scramble-robot/JRT2023_Arduino/パーツリスト.xlsx

Part | Name | Value
BZ1 | ブザー | UDB-05LFPN
C1 | 電解コンデンサ | 1000uF
C2 | 電解コンデンサ | 1000uF
CN1 | VHコネクタ | 2pin
CN2 | VHコネクタ | 2pin
CON1 | e-con | 3pin×4列
CON2 | e-con | 3pin×4列
CON3 | e-con | 3pin×4列
CON4 | e-con | 3pin×4列
CON5 | e-con | 3pin×4列
CON6 | e-con | 3pin×4列
CON7 | e-con | 4pin×4列
CON8 | e-con | 4pin
CON9 | e-con | 4pin
CON10 | e-con | 3pin×4列
IC1 | シールド用ArduinoMega | 8pin×7 6pin×1 10pin×2
LED1 | チップLED | 赤
LED2 | チップLED | 赤
LED3 | チップLED | 赤
LED4 | チップLED | 赤
LED5 | チップLED | 青
LED6 | チップLED | 青
LED7 | チップLED | 青
LED8 | チップLED | 青
LED9 | チップLED | 緑
LED10 | チップLED | 緑
LED11 | チップLED | 緑
LED12 | チップLED | 緑
LED13 | チップLED | 黄
LED14 | チップLED | 黄
LED15 | チップLED | 黄
LED16 | チップLED | 黄
LED17 | チップLED | 白
LED18 | チップLED | 白
R1 | チップ抵抗 | 1kΩ
R2 | チップ抵抗 | 1kΩ
R3 | チップ抵抗 | 1kΩ
R4 | チップ抵抗 | 1kΩ
R5 | チップ抵抗 | 1kΩ
R6 | チップ抵抗 | 1kΩ
R7 | チップ抵抗 | 1kΩ
R8 | チップ抵抗 | 1kΩ
R9 | チップ抵抗 | 1kΩ
R10 | チップ抵抗 | 1kΩ
R11 | チップ抵抗 | 1kΩ
R12 | チップ抵抗 | 1kΩ
R13 | チップ抵抗 | 1kΩ
R14 | チップ抵抗 | 1kΩ
R15 | チップ抵抗 | 1kΩ
R16 | チップ抵抗 | 1kΩ
R17 | チップ抵抗 | 10kΩ
R18 | チップ抵抗 | 1kΩ
R19 | チップ抵抗 | 1kΩ
R20 | チップ抵抗 | 1kΩ
R21 | チップ抵抗 | 1kΩ
RN1 | 集合抵抗 | 10kΩ
RN2 | 集合抵抗 | 10kΩ
RN3 | 集合抵抗 | 10kΩ
RN4 | 集合抵抗 | 10kΩ
T1 | チップトランジスタ | 2SC2712
