scramble-robot/JRT2023_Arduino/PDF/sch.pdf

# Motor

# LED

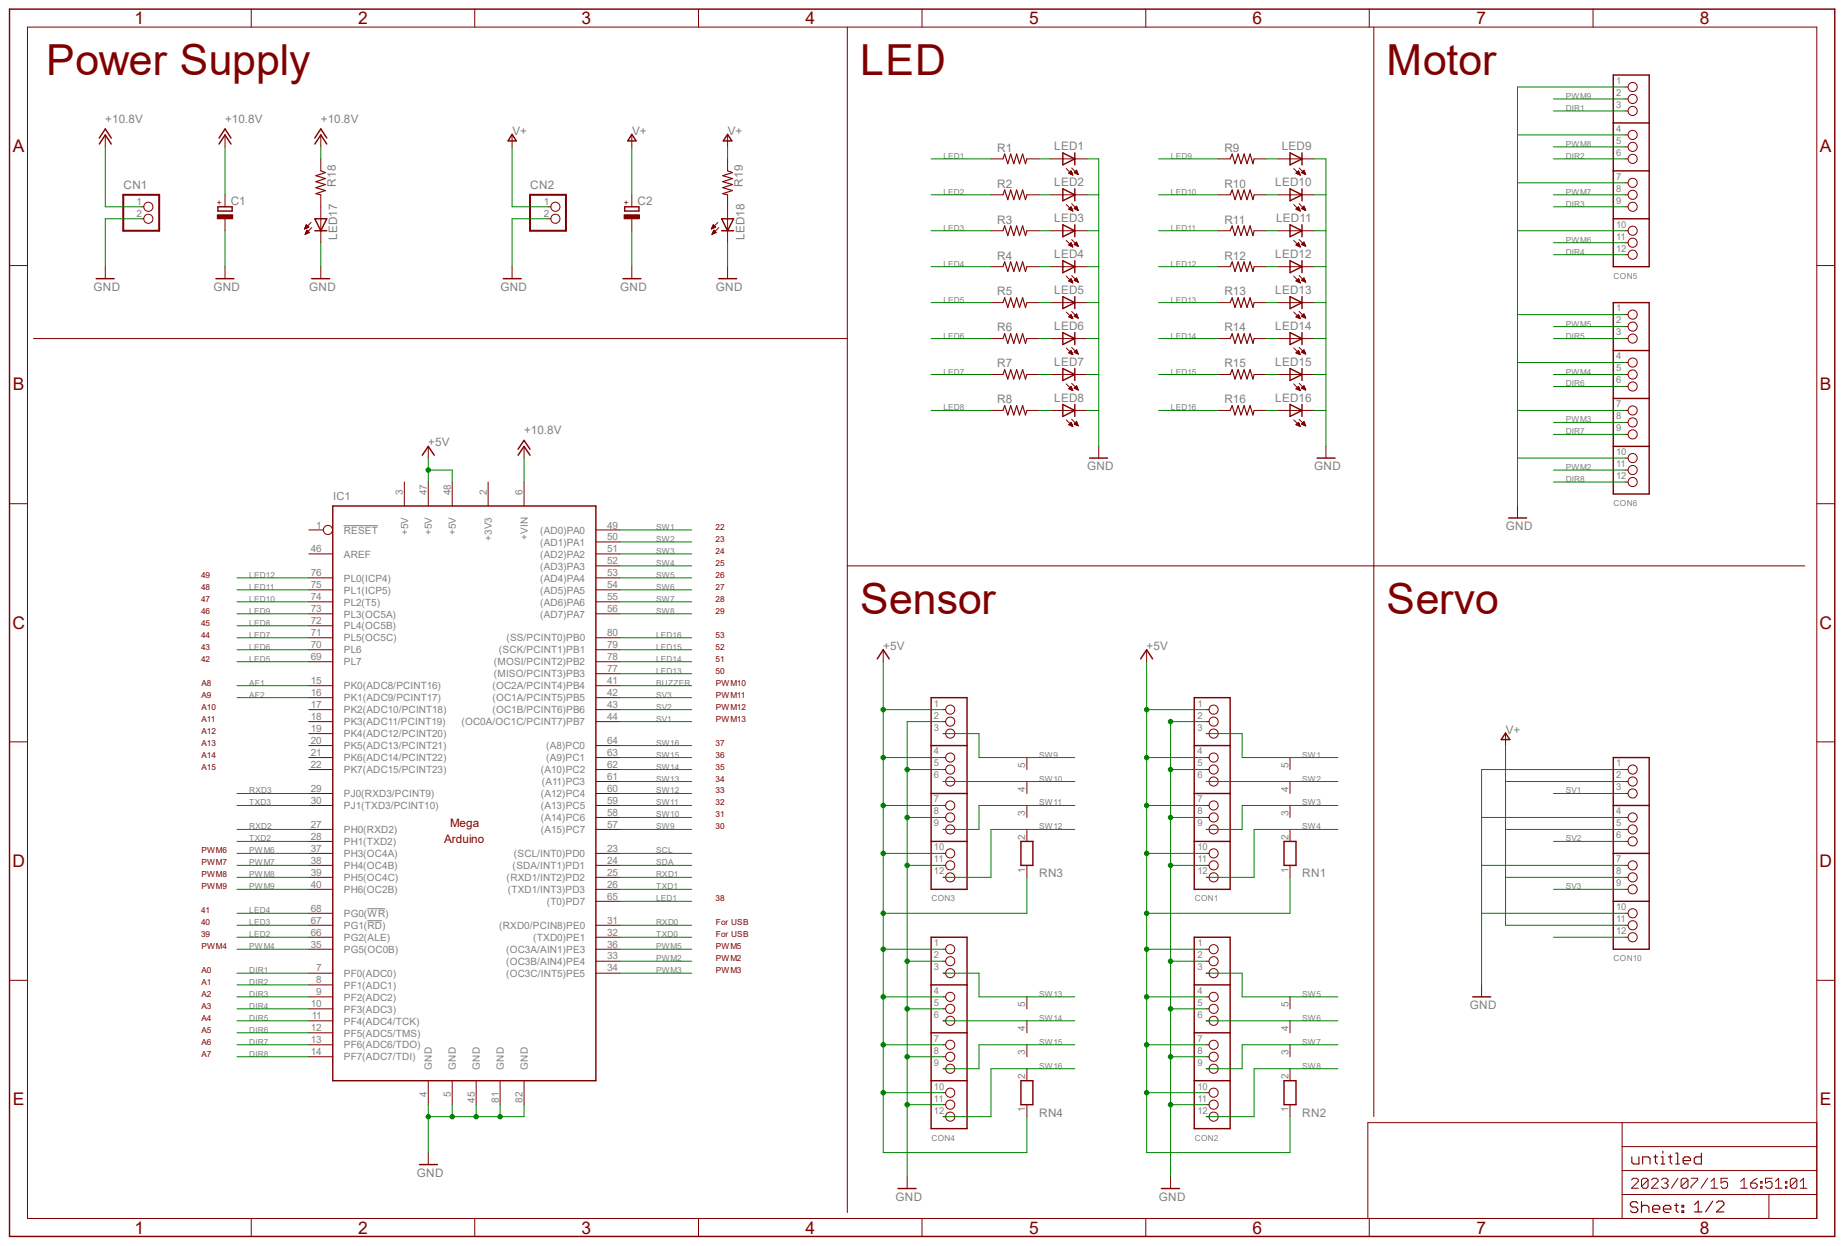
[picture p1: page 1]

Interface | AutoReferee | Buzzer

A

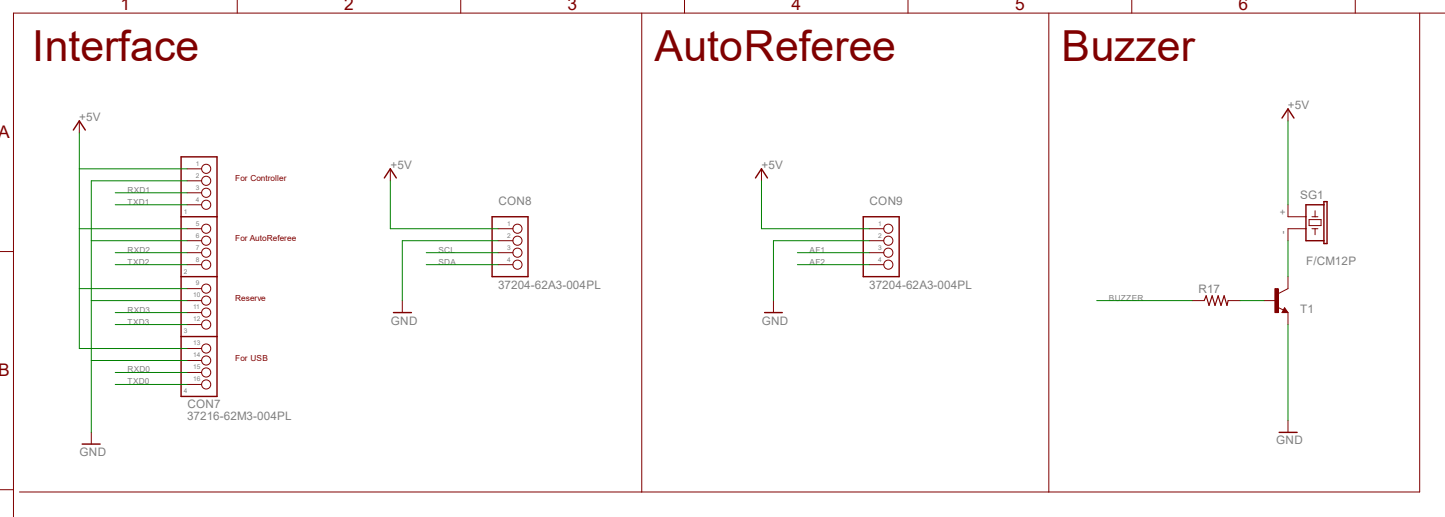
[picture p2: page 2]
GND; CON7; CON8; CON9; RXD1 TXD1; RXD2 TXD2; RXD3 TXD3; RXD0 TXD0; SCL SDA; BUZZER; For USB; For Controller; For AutoReferee; Reserve
