scramble-robot/JRT2023_Arduino/PDF/top.pdf

# R19 LED¹⁸ F/CM¹²P

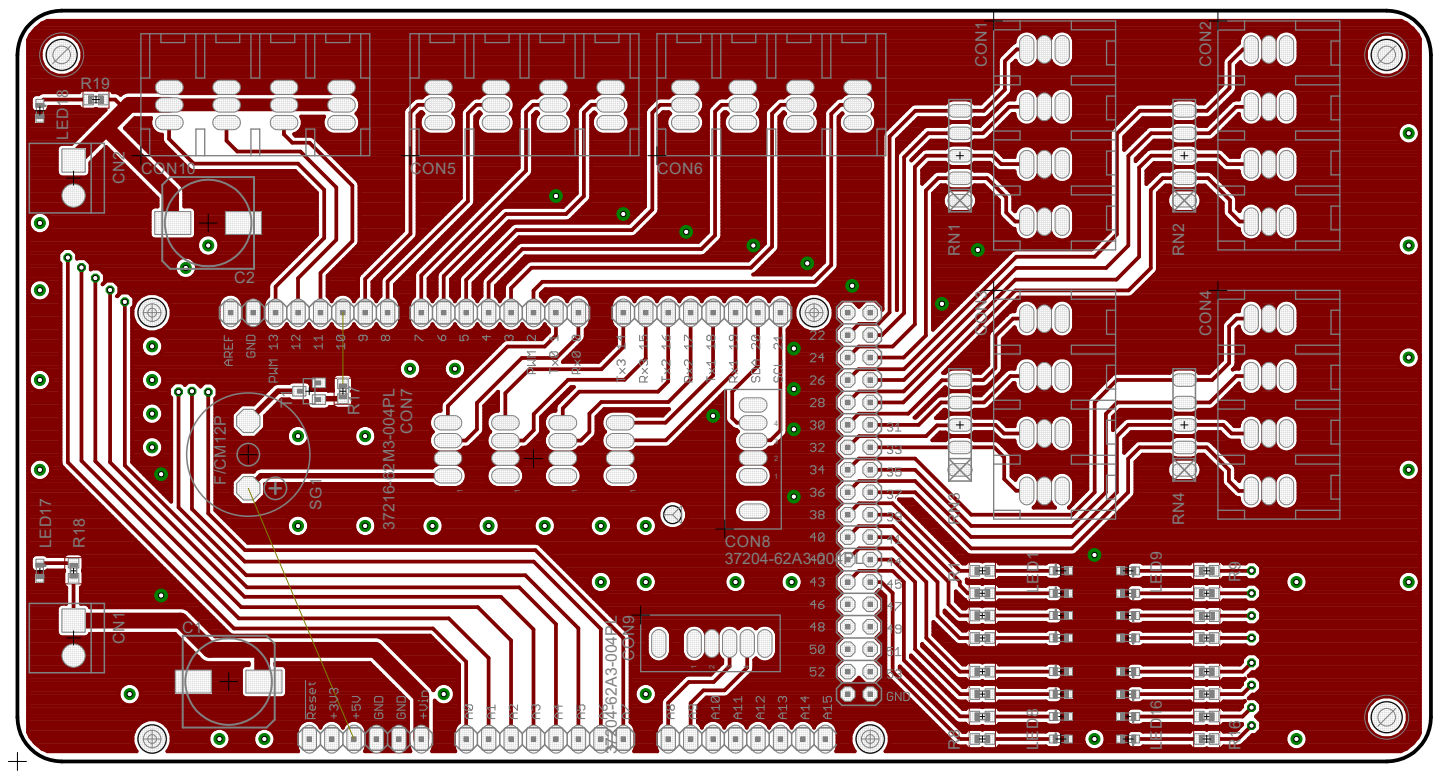
[picture p3: page 1]
CON1 CON2 CON3 CON4; CON10; CON5; CON6 1; RN¹; RN² RN³; RN⁴SG¹ T1; LED¹ LED⁸ R¹ R⁸; LED⁹ LED¹⁶; R⁹ R¹⁶ R¹⁷; CON⁷ 37216⁻62M³⁻⁰⁰⁴PL; CON8 CON⁹ CN¹ CN²; C2 LED¹⁷; R¹⁸; 37204-62A3-004PL 37204⁻62A³⁻⁰⁰⁴PL
