scramble-robot/JRT2023_Arduino/PDF/bottom.pdf

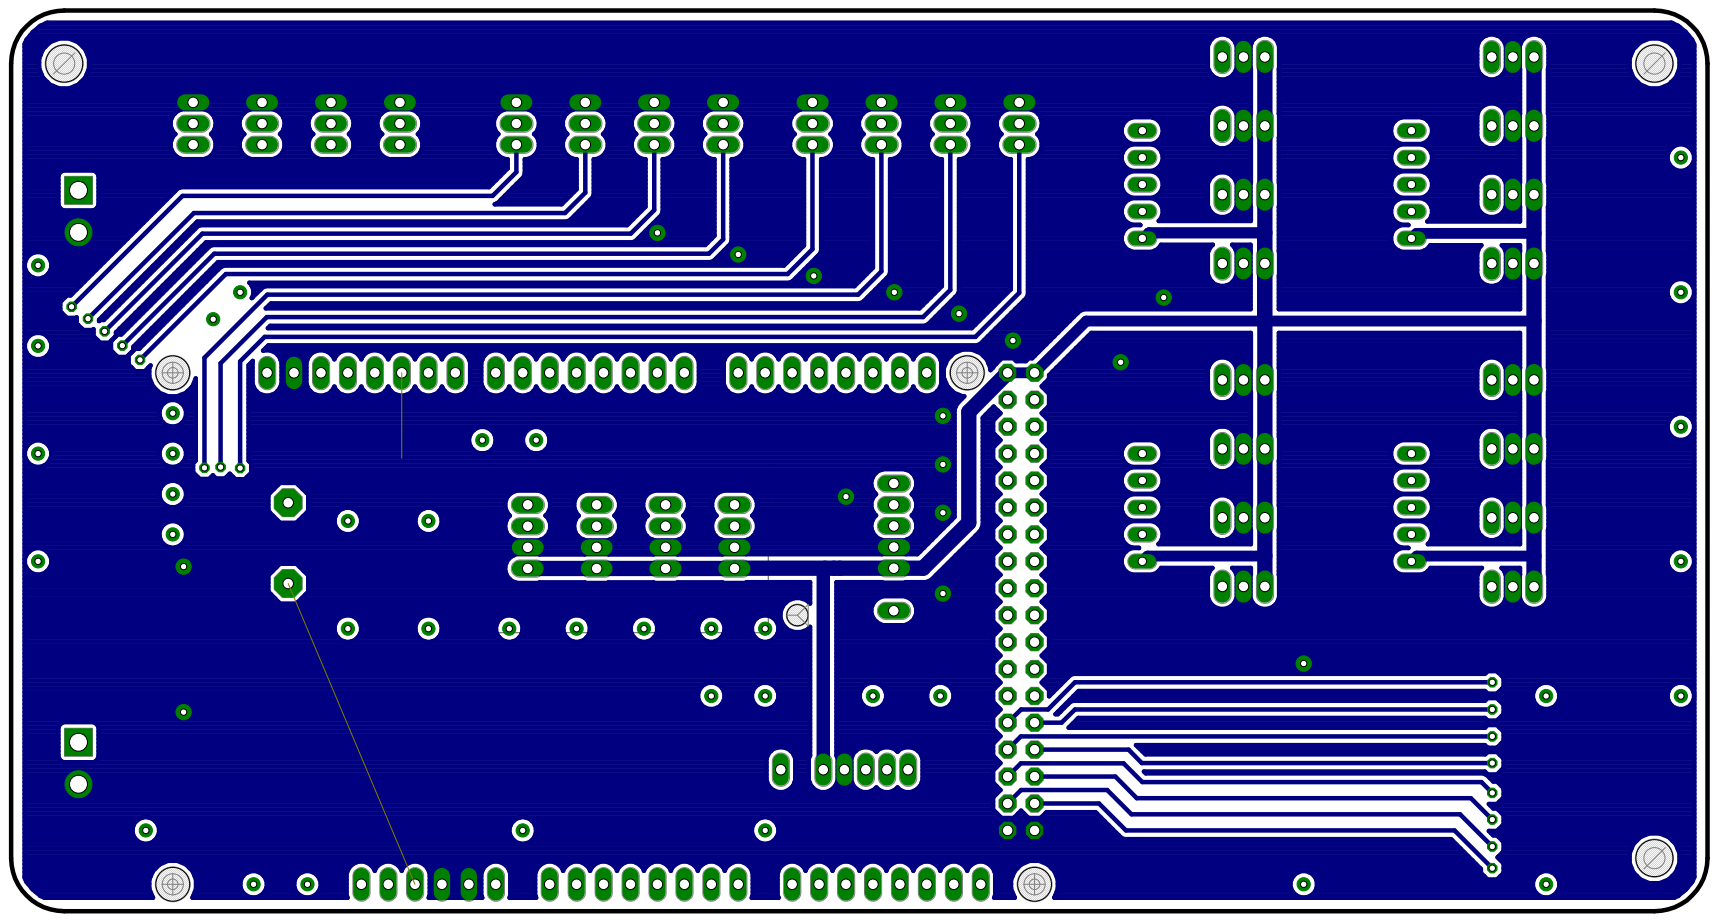
[picture p4: page 1]
