scramble-robot/JRT2023_Arduino/(commit log)

2023-08-20 新規作成
    [パーツリスト.xlsx]
2023-09-02 タイヤの制御変更，ローラの制御変更，コントローラのタイムアウト追加
2023-09-30 20230930
    ・CANモジュール用mcp2515ライブラリを同一フォルダに保存
    ・コントローラタイムアウト動作を修正
    ・非常停止スイッチ入力をSW16に追加
    ・OperationEnableのON条件に非常停止スイッチ解除とコントローラタイムアウトOFFを追加
    ・動作停止中ブザー音をオートレフェリー信号ON時のみに変更
    ・コメントを修正
    [JRTsample.ino, controller.ino, define.h]
